claudetete/ardlantic/layout/ardlantic/ardlantic.kicad_pcb

## KiCad design layout/ardlantic/ardlantic.kicad_pcb (2020-04-01)

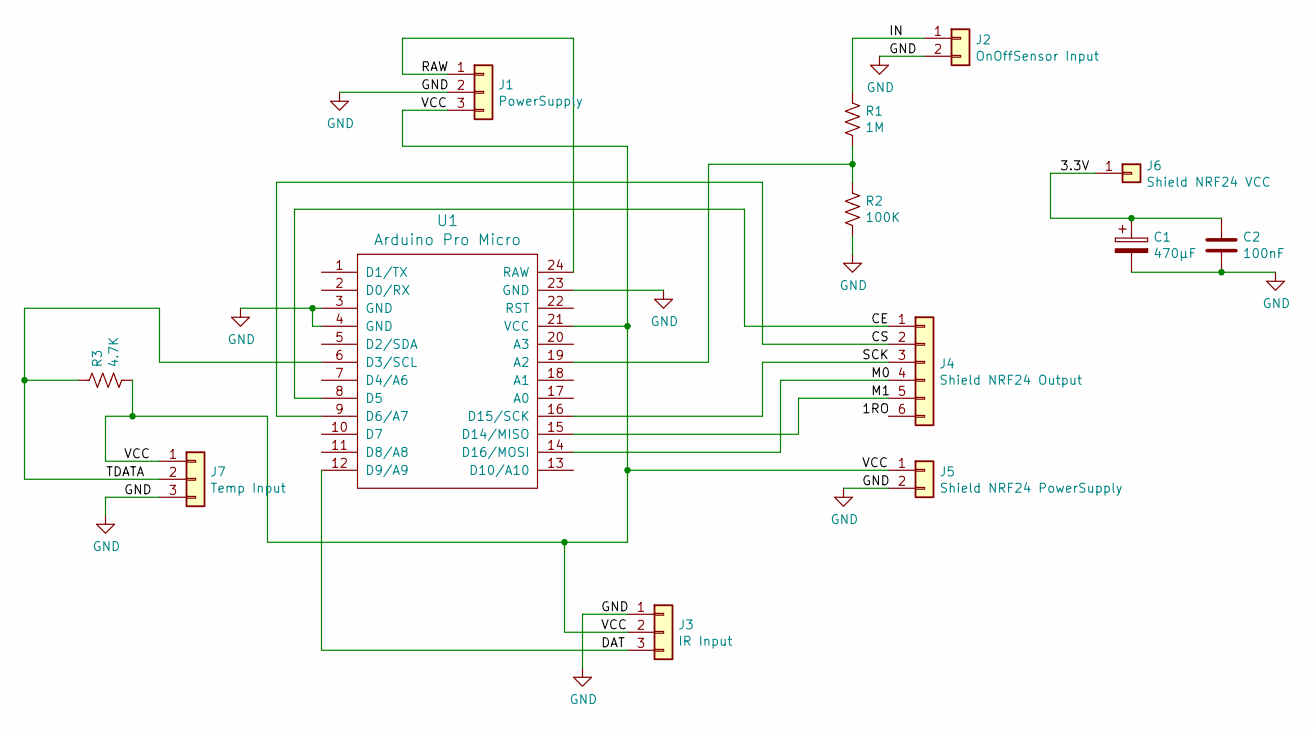
[picture p1: schematic ardlantic.sch]

Parts:
C1: 470µF; CP_Radial_D10.0mm_P5.00mm
C2: 100nF; CP_Radial_D5.0mm_P2.50mm
J1: PowerSupply; PinHeader_1x03_P2.54mm_Vertical
J2: OnOffSensor Input; PinHeader_1x02_P2.54mm_Vertical
J3: IR Input; PinHeader_1x03_P2.54mm_Vertical
J4: Shield NRF24 Output; PinHeader_1x06_P2.54mm_Vertical
J5: Shield NRF24 PowerSupply; PinHeader_1x02_P2.54mm_Vertical
J6: Shield NRF24 VCC; PinHeader_1x01_P2.54mm_Vertical
J7: Temp Input; PinHeader_1x03_P2.54mm_Vertical
R1: 1M; R_Axial_DIN0207_L6.3mm_D2.5mm_P10.16mm_Horizontal
R2: 100K; R_Axial_DIN0207_L6.3mm_D2.5mm_P10.16mm_Horizontal
R3: 4.7K; R_Axial_DIN0207_L6.3mm_D2.5mm_P10.16mm_Horizontal
U1: Arduino Pro Micro; ProMicro

Connections:
/3.3V: C1.1, C2.1, J6.1
/CE: J4.1, U1.8 (D5)
/CS: J4.2, U1.9 (D6/A7)
/DAT: J3.3, U1.12 (D9/A9)
/IN: J2.1, R1.1
/M0: J4.4, U1.14 (D16/MOSI)
/M1: J4.5, U1.15 (D14/MISO)
/RAW: J1.1, U1.24 (RAW)
/SCK: J4.3, U1.16 (D15/SCK)
/TDATA: J7.2, R3.1, U1.6 (D3/SCL)
/VCC: J1.3, J3.2, J5.1, J7.1, R3.2, U1.21 (VCC)
GND: C1.2, C2.2, J1.2, J2.2, J3.1, J5.2, J7.3, R2.2, U1.3 (GND), U1.4 (GND), U1.23 (GND)
unnamed: R1.2, R2.1, U1.19 (A2)

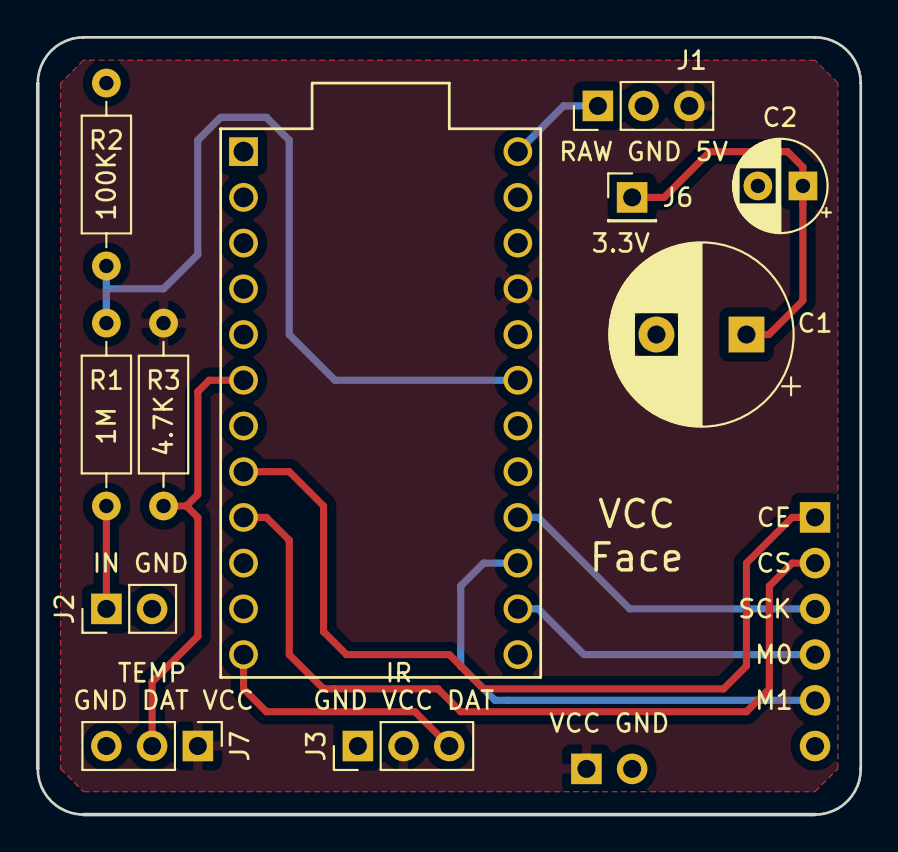
[picture p2: board ardlantic.kicad_pcb from above]

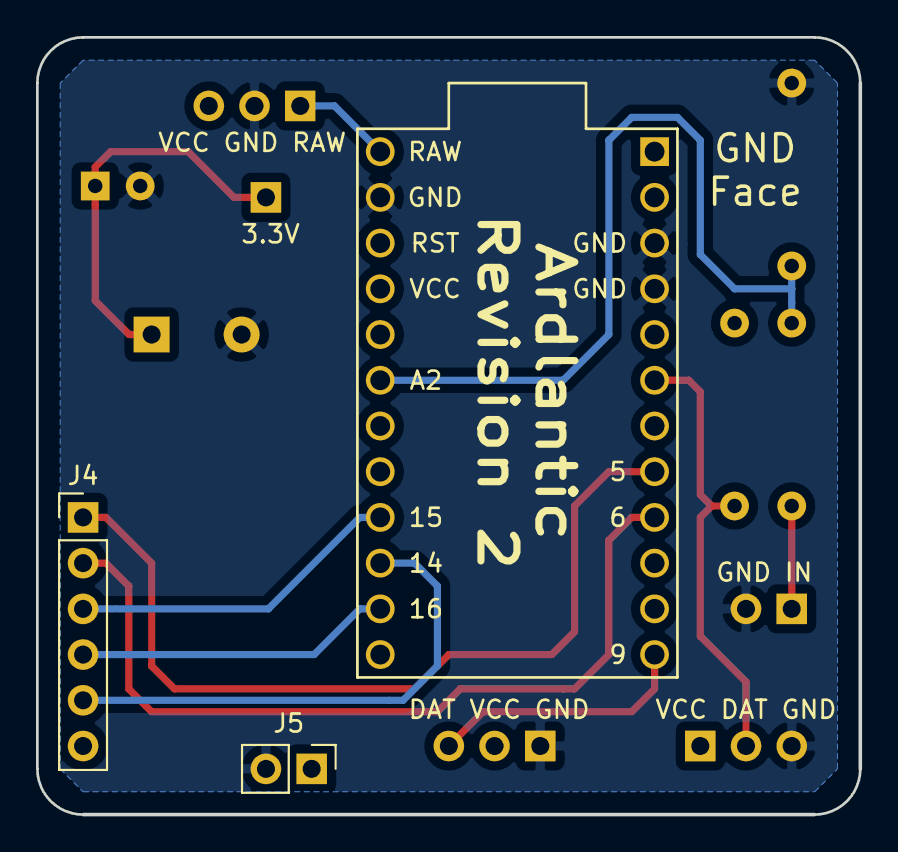
[picture p3: board ardlantic.kicad_pcb from below]

Board: 2 copper layers, 45.7 x 43.2 mm, 13 parts (2 on the bottom side), 13 nets.
