claudetete/ardlantic/(commit log)

2017-10-02 init repo with current project, useful to work on multiple computer
2017-10-17 implementation of MySensors in sketch (presentation, reception OK) + some test sketch + update lib for ardlantic about IR; FIXME crash during send of IR frame
    [Ardlantic.ino, MySensors_GatewaySerial.ino, MySensors_test_receiver.ino, blink_sparkfun.ino]
2017-10-20 add debug print
2018-12-22 Add missing command OFF + make not boolean value work + Pin A2 to read HVAC power + dzvents script for Domoticz + fix problem in Ardlantic lib
    [Ardlantic.ino, MySensors_GatewaySerial.ino]
2019-03-10 add first layout design
    [ardlantic-B.Cu.gbr, ardlantic-B.Mask.gbr, ardlantic-B.Paste.gbr, ardlantic-B.SilkS.gbr, ardlantic-Edge.Cuts.gbr, ardlantic-F.Cu.gbr, ardlantic-F.Mask.gbr, ardlantic-F.Paste.gbr]
2020-04-01 New layout revision with fix + fix mysensor pin + add temperature sensor
    [ardlantic.kicad_pcb, ardlantic.sch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]
