claudetete/ardlantic/(notices)

Notices in the files:
MySensors_GatewaySerial/MySensors_GatewaySerial.ino:
modify it under the terms of the GNU General Public License
